AlexFWall/airborne-particle-catcher/qr/airborne-particle-catcher-card.png

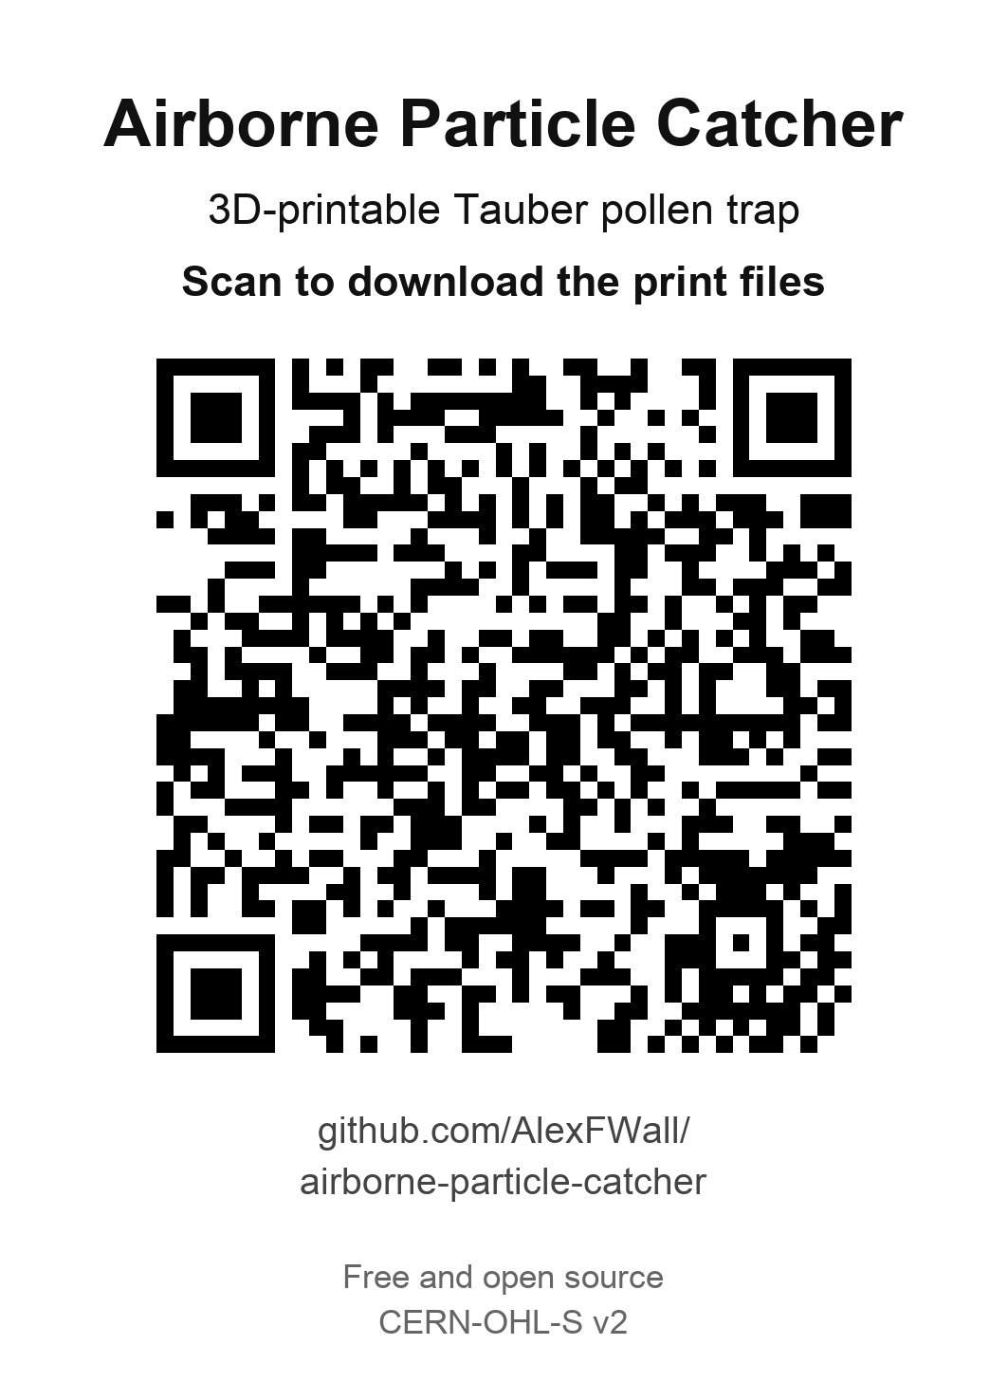
qr/airborne-particle-catcher-card.png
