AlexFWall/airborne-particle-catcher/3mf/trap_base_v1.7.3mf

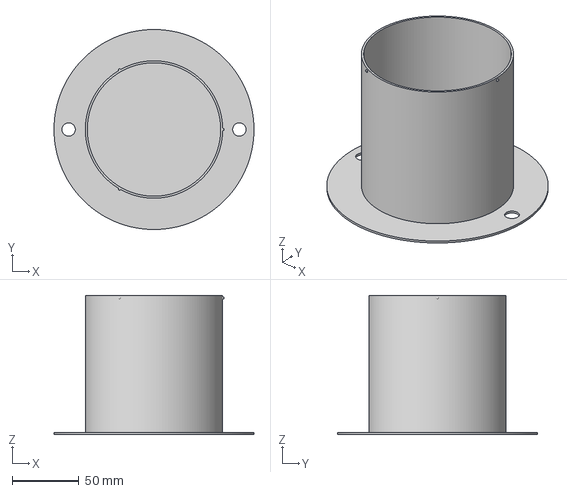
[picture p5: CAD file, 2026-11-09]
3mf/trap_base_v1.7.3mf
150.0 x 150.0 x 104.5 mm
