AlexFWall/airborne-particle-catcher/3mf/trap_collar_v1.7.3mf

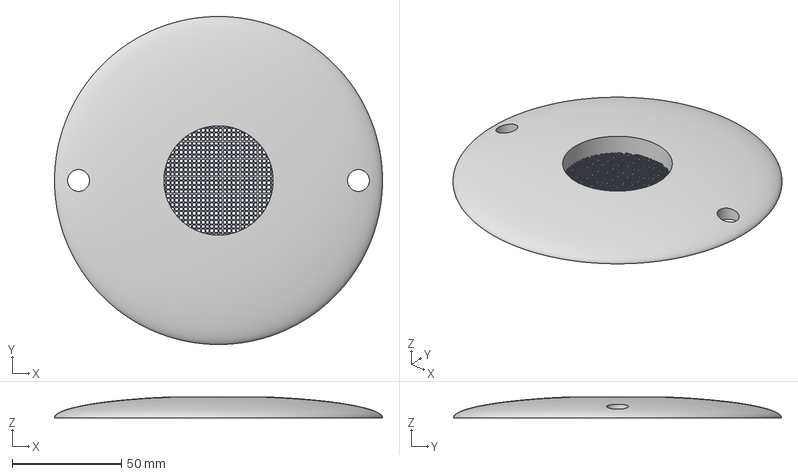
[picture p6: CAD file, 2026-11-09]
3mf/trap_collar_v1.7.3mf
150.0 x 150.0 x 9.43 mm
