AlexFWall/airborne-particle-catcher/(list of files, cad)

Other CAD files:
stl/trap_base_v1.7.stl
stl/trap_collar_v1.7.stl
