AlexFWall/airborne-particle-catcher/(commit log)

2026-11-09 Airborne Particle Catcher v1.7: design files, print and assembly instructions
    Two-part 3D-printable Tauber pollen trap replicating the Tauber (1974)
    dimensions: 100 mm bore, 100 mm deep container; 150 mm collar with a 50 mm
    orifice. Base and collar join with three snap lugs at 0, 120 and 240 degrees.
    Includes the original 3MF exports, STL conversions recentred on the build
    plate, print settings for PETG and for the PLA prototype, assembly and
    deployment instructions, and the CERN-OHL-S v2 licence.
    [trap_base_v1.7.3mf, trap_base_v1.7.stl, trap_collar_v1.7.3mf, trap_collar_v1.7.stl]
2026-11-09 Add QR code linking to the repository, as a bare symbol and a printable card
    Version 6 symbol at error correction level H, so it survives 30 per cent
    damage or obscuring. Supplied as vector SVG and 300 dpi PNG, bare and on a
    90 x 125 mm labelled card, with the generating script.
